Jay-Damodaran/SepsisDetector/README.md

# SepsisDetector
BME 261L medical device project focused on designing a sepsis early warning system. The device measures heart rate, breathing rate, and shivering, and uses a speaker that produces a loud sound to alert the patient.
