Jay-Damodaran/SepsisDetector/Experimental/dual_sensor_data1.csv

Ax | Ay | Az | Amag | Ax2 | Ay2 | Az2 | Amag2
-1.89 | -9.64 | 0.18 | 9.82 | -9.57 | 0.07 | -2.36 | 9.85
-1.94 | -9.64 | 0.18 | 9.83 | -9.59 | 0.08 | -2.37 | 9.88
-1.93 | -9.65 | 0.17 | 9.84 | -9.59 | 0.11 | -2.37 | 9.88
-1.92 | -9.63 | 0.16 | 9.82 | -9.60 | 0.11 | -2.39 | 9.89
-1.90 | -9.64 | 0.15 | 9.82 | -9.58 | 0.11 | -2.39 | 9.87
-1.91 | -9.63 | 0.13 | 9.82 | -9.56 | 0.09 | -2.38 | 9.85
-1.91 | -9.61 | 0.12 | 9.80 | -9.58 | 0.11 | -2.39 | 9.87
-1.89 | -9.62 | 0.14 | 9.80 | -9.55 | 0.09 | -2.41 | 9.85
-1.91 | -9.60 | 0.14 | 9.78 | -9.57 | 0.10 | -2.40 | 9.87
-1.92 | -9.60 | 0.16 | 9.79 | -9.56 | 0.11 | -2.39 | 9.85
-1.92 | -9.59 | 0.16 | 9.78 | -9.57 | 0.11 | -2.37 | 9.86
-1.91 | -9.61 | 0.14 | 9.80 | -9.56 | 0.08 | -2.40 | 9.86
-1.92 | -9.60 | 0.14 | 9.79 | -9.56 | 0.08 | -2.38 | 9.85
-1.87 | -9.45 | 0.03 | 9.63 | -9.54 | 0.10 | -2.39 | 9.84
-1.94 | -9.70 | 0.19 | 9.89 | -9.56 | 0.06 | -2.37 | 9.85
-1.91 | -9.66 | 0.18 | 9.85 | -9.61 | 0.08 | -2.39 | 9.90
-1.91 | -9.64 | 0.14 | 9.83 | -9.60 | 0.11 | -2.33 | 9.88
-1.88 | -9.60 | 0.13 | 9.78 | -9.60 | 0.09 | -2.37 | 9.88
-1.89 | -9.54 | 0.16 | 9.73 | -9.58 | 0.12 | -2.34 | 9.86
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
