Jay-Damodaran/SepsisDetector/Experimental/dual_sensor_data10.csv

Ax | Ay | Az | Amag | Ax2 | Ay2 | Az2 | Amag2
-2.30 | -9.67 | 0.67 | 9.96 | -9.69 | 0.06 | -2.07 | 9.91
-2.29 | -9.65 | 0.70 | 9.94 | -9.68 | 0.06 | -2.07 | 9.90
-2.28 | -9.62 | 0.71 | 9.91 | -9.66 | 0.06 | -2.10 | 9.88
-2.29 | -9.62 | 0.70 | 9.91 | -9.66 | 0.09 | -2.09 | 9.89
-2.32 | -9.62 | 0.71 | 9.92 | -9.63 | 0.09 | -2.11 | 9.86
-2.33 | -9.58 | 0.72 | 9.88 | -9.61 | 0.06 | -2.08 | 9.84
-2.28 | -9.57 | 0.73 | 9.86 | -9.59 | 0.07 | -2.09 | 9.82
-2.30 | -9.57 | 0.72 | 9.87 | -9.61 | 0.04 | -2.14 | 9.85
-2.23 | -9.56 | 0.71 | 9.84 | -9.62 | 0.04 | -2.10 | 9.84
-2.23 | -9.60 | 0.68 | 9.88 | -9.63 | 0.05 | -2.11 | 9.86
-2.27 | -9.61 | 0.71 | 9.90 | -9.61 | 0.10 | -2.10 | 9.84
-2.25 | -9.58 | 0.68 | 9.87 | -9.64 | 0.08 | -2.11 | 9.87
-2.26 | -9.61 | 0.67 | 9.90 | -9.63 | 0.07 | -2.09 | 9.85
-2.26 | -9.60 | 0.67 | 9.89 | -9.62 | 0.06 | -2.11 | 9.85
-2.28 | -9.62 | 0.69 | 9.91 | -9.63 | 0.08 | -2.15 | 9.87
-2.31 | -9.62 | 0.64 | 9.91 | -9.66 | 0.05 | -2.13 | 9.89
-2.30 | -9.63 | 0.66 | 9.92 | -9.62 | 0.05 | -2.15 | 9.85
-2.30 | -9.62 | 0.71 | 9.92 | -9.63 | 0.06 | -2.16 | 9.87
-2.28 | -9.61 | 0.67 | 9.90 | -9.64 | 0.05 | -2.16 | 9.88
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
