Jay-Damodaran/SepsisDetector/Experimental/dual_sensor_data2.csv

Ax | Ay | Az | Amag | Ax2 | Ay2 | Az2 | Amag2
-1.72 | -9.68 | 0.06 | 9.84 | -9.66 | -0.10 | -1.99 | 9.86
-1.67 | -9.71 | 0.05 | 9.85 | -9.73 | -0.09 | -2.01 | 9.93
-1.70 | -9.68 | 0.05 | 9.83 | -9.67 | -0.11 | -1.99 | 9.88
-1.73 | -9.75 | 0.12 | 9.91 | -9.68 | -0.11 | -1.99 | 9.89
-1.74 | -9.71 | 0.11 | 9.87 | -9.67 | -0.09 | -1.98 | 9.87
-1.77 | -9.71 | 0.16 | 9.87 | -9.66 | -0.09 | -1.94 | 9.86
-1.73 | -9.66 | 0.11 | 9.81 | -9.65 | -0.11 | -1.97 | 9.85
-1.72 | -9.63 | 0.07 | 9.78 | -9.66 | -0.08 | -1.93 | 9.85
-1.70 | -9.64 | 0.05 | 9.79 | -9.64 | -0.08 | -1.94 | 9.83
-1.70 | -9.66 | 0.05 | 9.81 | -9.66 | -0.08 | -1.94 | 9.85
-1.69 | -9.64 | 0.08 | 9.79 | -9.64 | -0.11 | -1.97 | 9.84
-1.72 | -9.66 | 0.09 | 9.82 | -9.64 | -0.09 | -1.97 | 9.84
-1.72 | -9.63 | -0.03 | 9.78 | -9.66 | -0.08 | -2.04 | 9.87
-1.77 | -9.65 | 0.07 | 9.81 | -9.64 | -0.07 | -1.98 | 9.84
-1.77 | -9.65 | 0.05 | 9.81 | -9.64 | -0.11 | -1.96 | 9.84
-1.69 | -9.66 | 0.05 | 9.81 | -9.63 | -0.05 | -1.92 | 9.82
-1.77 | -9.68 | 0.05 | 9.84 | -9.69 | -0.05 | -2.02 | 9.89
-1.80 | -9.70 | 0.11 | 9.86 | -9.64 | -0.07 | -2.03 | 9.85
-1.77 | -9.68 | 0.13 | 9.84 | -9.67 | -0.06 | -1.95 | 9.86
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
