Jay-Damodaran/SepsisDetector/Experimental/dual_sensor_data3.csv

Ax | Ay | Az | Amag | Ax2 | Ay2 | Az2 | Amag2
-1.73 | -9.64 | 0.11 | 9.80 | -9.59 | -0.05 | -2.15 | 9.83
-1.69 | -9.64 | 0.09 | 9.79 | -9.63 | -0.05 | -2.10 | 9.86
-1.73 | -9.68 | 0.11 | 9.84 | -9.65 | -0.05 | -2.15 | 9.88
-1.81 | -9.73 | 0.14 | 9.90 | -9.68 | -0.05 | -2.19 | 9.92
-1.80 | -9.77 | 0.02 | 9.93 | -9.60 | -0.08 | -2.03 | 9.81
-1.71 | -9.60 | 0.23 | 9.75 | -9.61 | -0.06 | -2.19 | 9.85
-1.68 | -9.67 | 0.11 | 9.81 | -9.65 | -0.08 | -2.20 | 9.90
-1.73 | -9.80 | 0.18 | 9.95 | -9.61 | -0.09 | -1.97 | 9.81
-1.70 | -9.62 | -0.02 | 9.77 | -9.68 | -0.04 | -2.08 | 9.90
-1.76 | -9.66 | 0.16 | 9.82 | -9.64 | -0.07 | -2.25 | 9.90
-1.78 | -9.69 | 0.19 | 9.85 | -9.60 | -0.08 | -2.16 | 9.84
-1.72 | -9.54 | 0.13 | 9.69 | -9.60 | -0.07 | -2.09 | 9.83
-1.72 | -9.60 | 0.12 | 9.76 | -9.63 | -0.08 | -2.08 | 9.85
-1.78 | -9.62 | 0.10 | 9.79 | -9.61 | -0.06 | -2.09 | 9.84
-1.78 | -9.68 | 0.07 | 9.84 | -9.63 | -0.02 | -2.06 | 9.85
-1.75 | -9.71 | 0.19 | 9.87 | -9.73 | -0.03 | -2.10 | 9.96
-1.73 | -9.74 | 0.15 | 9.89 | -9.77 | -0.04 | -2.13 | 9.99
-1.73 | -9.76 | 0.18 | 9.92 | -9.72 | -0.07 | -2.09 | 9.94
-1.78 | -9.73 | 0.25 | 9.89 | -9.69 | -0.05 | -2.11 | 9.91
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
