Jay-Damodaran/SepsisDetector/Experimental/dual_sensor_data4.csv

Ax | Ay | Az | Amag | Ax2 | Ay2 | Az2 | Amag2
-1.86 | -9.65 | 0.03 | 9.83 | -9.66 | -0.13 | -2.09 | 9.89
-1.87 | -9.63 | -0.01 | 9.81 | -9.70 | -0.14 | -2.10 | 9.93
-1.91 | -9.68 | 0.07 | 9.87 | -9.66 | -0.13 | -2.15 | 9.90
-1.89 | -9.71 | 0.12 | 9.89 | -9.68 | -0.12 | -2.05 | 9.90
-1.86 | -9.67 | 0.12 | 9.85 | -9.69 | -0.14 | -2.10 | 9.91
-1.92 | -9.66 | 0.06 | 9.85 | -9.64 | -0.15 | -2.12 | 9.87
-1.92 | -9.60 | 0.03 | 9.79 | -9.66 | -0.13 | -2.13 | 9.89
-1.90 | -9.65 | 0.01 | 9.83 | -9.66 | -0.13 | -2.10 | 9.89
-1.88 | -9.64 | 0.00 | 9.82 | -9.66 | -0.12 | -2.13 | 9.89
-1.84 | -9.63 | -0.02 | 9.81 | -9.61 | -0.14 | -2.13 | 9.85
-1.82 | -9.64 | 0.02 | 9.81 | -9.64 | -0.16 | -2.11 | 9.87
-1.87 | -9.65 | 0.03 | 9.83 | -9.63 | -0.14 | -2.12 | 9.86
-1.87 | -9.64 | 0.04 | 9.82 | -9.61 | -0.15 | -2.15 | 9.85
-1.86 | -9.66 | 0.04 | 9.83 | -9.62 | -0.12 | -2.13 | 9.86
-1.89 | -9.65 | 0.06 | 9.83 | -9.63 | -0.11 | -2.17 | 9.87
-1.89 | -9.61 | 0.05 | 9.80 | -9.62 | -0.16 | -2.15 | 9.86
-1.87 | -9.62 | 0.07 | 9.80 | -9.65 | -0.17 | -2.18 | 9.89
-1.87 | -9.65 | 0.05 | 9.82 | -9.63 | -0.15 | -2.17 | 9.87
-1.88 | -9.63 | 0.06 | 9.81 | -9.63 | -0.13 | -2.14 | 9.86
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
