Jay-Damodaran/SepsisDetector/Experimental/dual_sensor_data5.csv

Ax | Ay | Az | Amag | Ax2 | Ay2 | Az2 | Amag2
-1.99 | -9.63 | 0.14 | 9.84 | -9.64 | -0.10 | -2.27 | 9.90
-2.01 | -9.65 | 0.11 | 9.86 | -9.66 | -0.11 | -2.25 | 9.92
-2.01 | -9.64 | 0.15 | 9.85 | -9.64 | -0.10 | -2.25 | 9.89
-2.06 | -9.66 | 0.19 | 9.88 | -9.63 | -0.09 | -2.26 | 9.89
-2.09 | -9.63 | 0.18 | 9.86 | -9.62 | -0.08 | -2.24 | 9.88
-2.06 | -9.61 | 0.16 | 9.83 | -9.60 | -0.06 | -2.22 | 9.86
-2.04 | -9.59 | 0.13 | 9.81 | -9.60 | -0.06 | -2.22 | 9.85
-2.03 | -9.58 | 0.11 | 9.79 | -9.60 | -0.09 | -2.20 | 9.85
-2.04 | -9.57 | 0.12 | 9.78 | -9.60 | -0.10 | -2.18 | 9.85
-2.03 | -9.60 | 0.13 | 9.81 | -9.60 | -0.08 | -2.23 | 9.86
-2.05 | -9.59 | 0.11 | 9.80 | -9.61 | -0.08 | -2.22 | 9.87
-2.03 | -9.56 | 0.13 | 9.77 | -9.59 | -0.10 | -2.23 | 9.85
-2.05 | -9.55 | 0.11 | 9.77 | -9.58 | -0.09 | -2.24 | 9.84
-2.06 | -9.52 | -0.08 | 9.74 | -9.60 | -0.07 | -2.23 | 9.85
-2.04 | -9.59 | 0.04 | 9.81 | -9.62 | -0.10 | -2.23 | 9.88
-2.03 | -9.61 | 0.03 | 9.82 | -9.59 | -0.08 | -2.22 | 9.84
-2.06 | -9.64 | 0.11 | 9.86 | -9.67 | -0.08 | -2.34 | 9.95
-2.06 | -9.65 | 0.15 | 9.87 | -9.60 | -0.11 | -2.25 | 9.87
-2.02 | -9.60 | 0.14 | 9.81 | -9.68 | -0.08 | -2.23 | 9.94
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
