Jay-Damodaran/SepsisDetector/(commit log)

2026-02-03 First script; buzzer control/volume
    [alarm.ino]
2026-02-05 Adding low battery sound
2026-02-05 Tests for IMUs
2026-03-24 battery check code
2026-04-15 shifted to HR module after experimentation
    [dual_sensor_data1.csv, dual_sensor_data10.csv, dual_sensor_data2.csv, dual_sensor_data3.csv, dual_sensor_data4.csv, dual_sensor_data5.csv, dual_sensor_data6.csv, dual_sensor_data7.csv]
2026-04-23 Final sepsor system code with some modifications to HR calc and low battery warning
2026-04-23 Added updated battery check code and code to put MCU in deep sleep
2026-08-31 Adding Kicad schematic for device
    [SepsDetectCircuit.kicad_pcb, SepsDetectCircuit.kicad_sch]
2026-09-09 Add remaining circuit schematics and symbols
    [Adafruit_LSM6DSOX.kicad_pcb, Adafruit_LSM6DSOX.kicad_sch]
